odindino/UHV-Suitcase/README.md

# UHV-Suitcase
The suitcase design for UHV experiment

Materials
1. CF 35 blank/viewport
2. VAT Mini Gate Valve (CF35)
3. SAES Z100 ion pump
4. UHV Design wobblestick WSG40-300
5. Homemade 2x Sample holder and 2x tip holder
