odindino/UHV-Suitcase/Suitcase_odino_2025_rev-1/shelf/HS.SLDASM

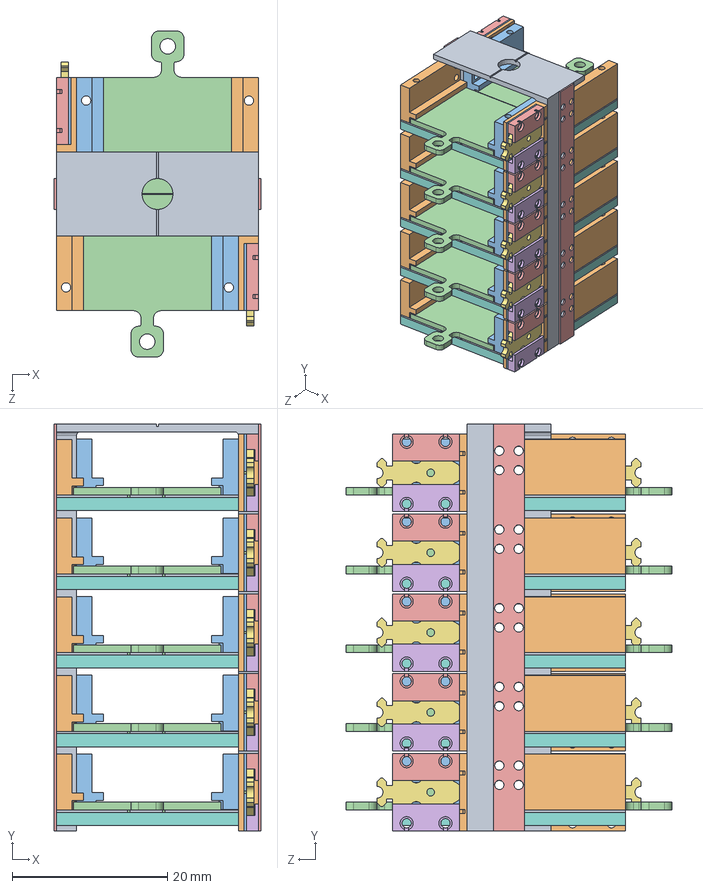
[picture p1: CAD file, 2025-01-05]
Suitcase_odino_2025_rev-1/shelf/HS.SLDASM
26.7 x 52.5 x 42.1 mm
sample shelf
tip holder bottom x 10
tip holder 蓋子 x 10
sample holder 彈片 x 30
tip holder left side x 10
tip holder right side x 10
normal-tip holder x 10
sample holder bottom x 10
sample holder lip x 10
sample holder one layer left side x 10
sample holder one layer right side x 10
flag style sample plate_ZL x 10
sample shelf 板子 x 2
