odindino/UHV-Suitcase/Suitcase_odino_2025_rev-1/wobble stick_tube_rotatable.SLDPRT.SLDASM

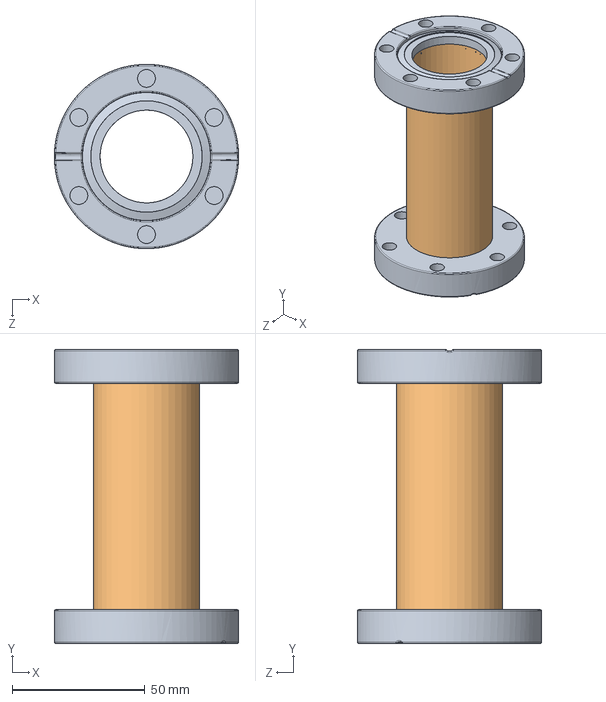
[picture p2: CAD file, 2025-01-05]
Suitcase_odino_2025_rev-1/wobble stick_tube_rotatable.SLDPRT.SLDASM
69.3 x 110.6 x 69.3 mm
P104704_Bored Conflat Flange, 2.750 inch, Bored 1.50 in., Through Holes, Rotatable x 2
wobble stick_tube
