odindino/UHV-Suitcase/Suitcase_odino_2025_rev-1/Ion pump_tube_rotatable.SLDASM

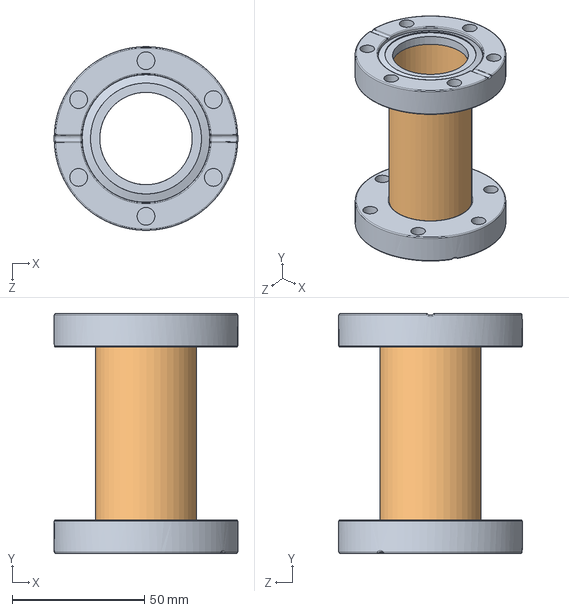
[picture p3: CAD file, 2025-01-05]
Suitcase_odino_2025_rev-1/Ion pump_tube_rotatable.SLDASM
69.3 x 90.6 x 69.3 mm
P104704_Bored Conflat Flange, 2.750 inch, Bored 1.50 in., Through Holes, Rotatable x 2
Ion pump_tube
