odindino/UHV-Suitcase/Suitcase_odino_2025_rev-1/Gate valve_tube_rotatable.SLDASM

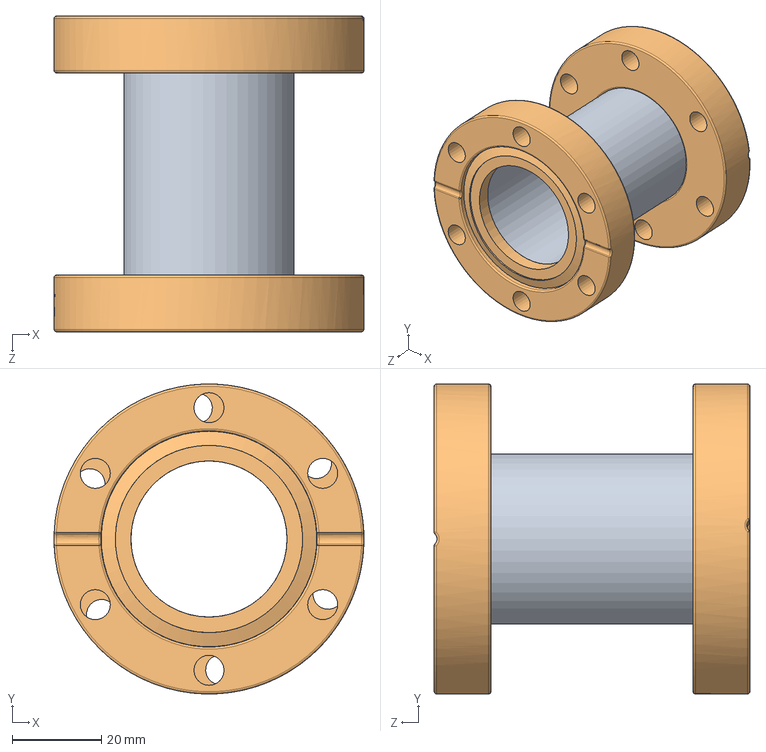
[picture p4: CAD file, 2025-01-05]
Suitcase_odino_2025_rev-1/Gate valve_tube_rotatable.SLDASM
69.3 x 69.3 x 70.6 mm
Gate valve_tube
P104704_Bored Conflat Flange, 2.750 inch, Bored 1.50 in., Through Holes, Rotatable x 2
