odindino/UHV-Suitcase/Suitcase_odino_2025_rev-1/shelf/HS-HS.SLDPRT

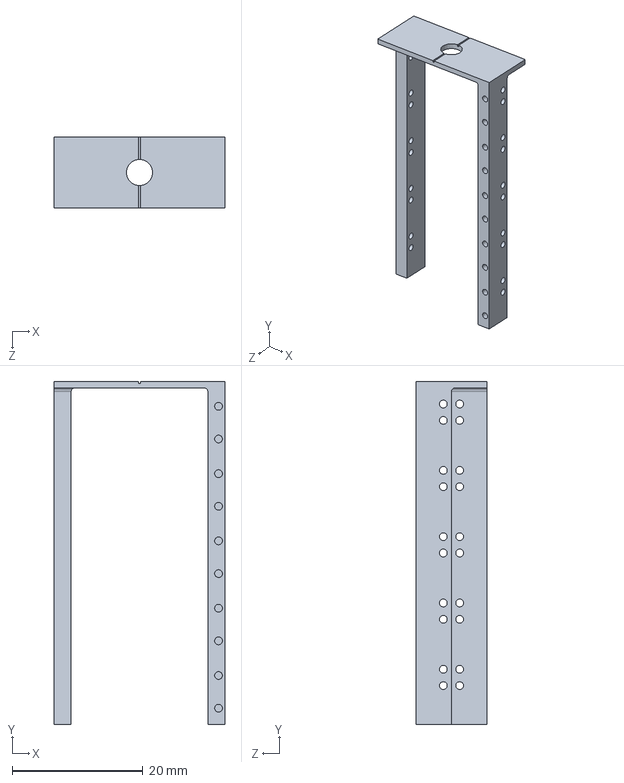
[picture p5: CAD file, 2025-01-05]
Suitcase_odino_2025_rev-1/shelf/HS-HS.SLDPRT
26.1 x 52.5 x 10.8 mm
