odindino/UHV-Suitcase/Suitcase_odino_2025_rev-1/wobble stick_tube.SLDPRT

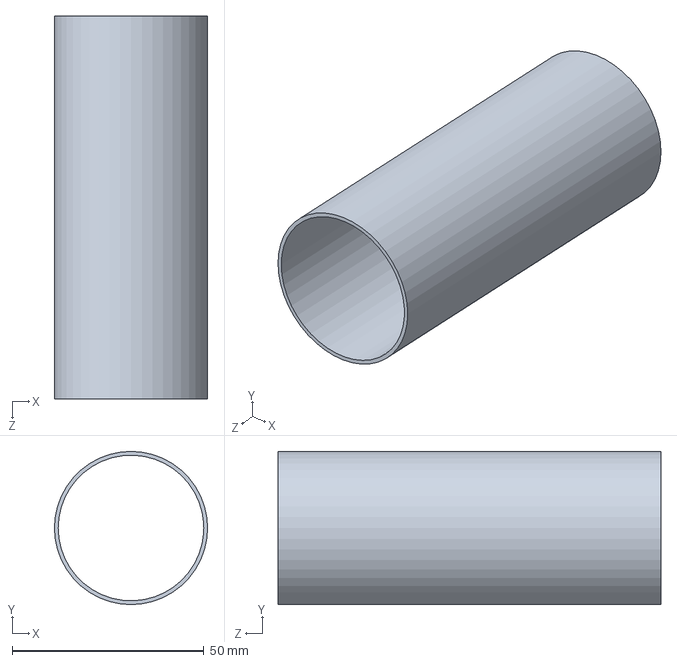
[picture p6: CAD file, 2025-01-05]
Suitcase_odino_2025_rev-1/wobble stick_tube.SLDPRT
40.0 x 40.0 x 100.0 mm
