odindino/UHV-Suitcase/Suitcase_odino_2025_rev-1/shelf/HS-HSB.SLDPRT

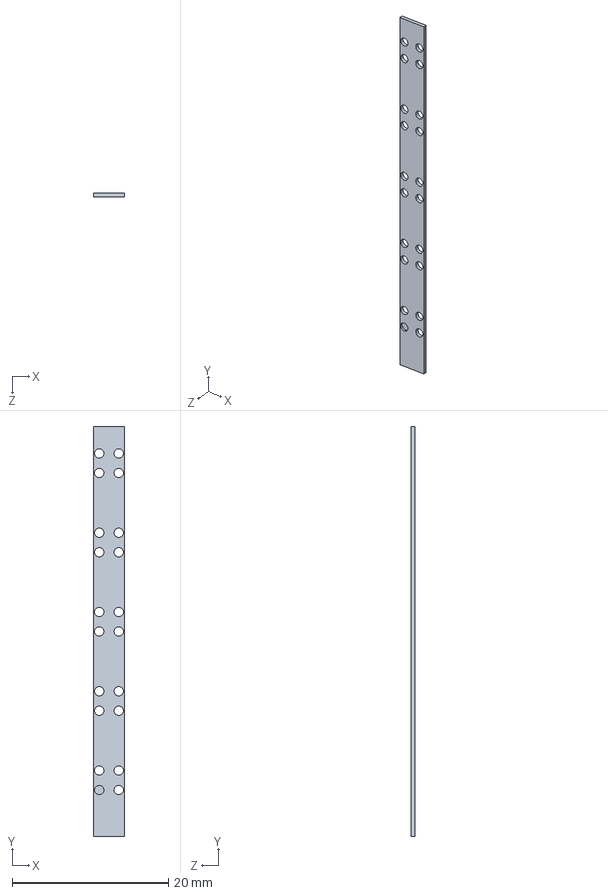
[picture p7: CAD file, 2025-01-05]
Suitcase_odino_2025_rev-1/shelf/HS-HSB.SLDPRT
4.00 x 52.5 x 0.5 mm
