odindino/UHV-Suitcase/Suitcase_odino_2025_rev-1/B1363B.step.SLDPRT

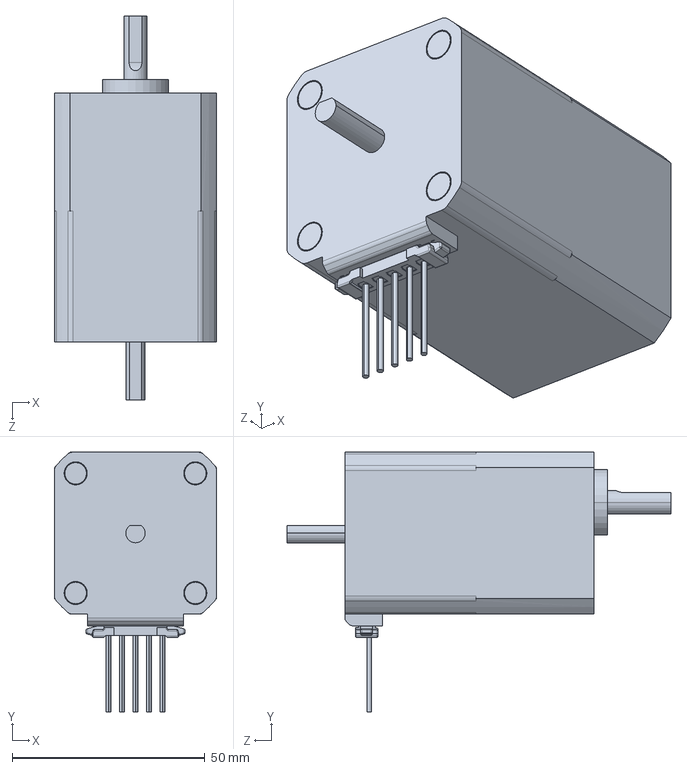
[picture p8: CAD file, 2025-01-05]
Suitcase_odino_2025_rev-1/B1363B.step.SLDPRT
42.0 x 67.3 x 99.5 mm
