odindino/UHV-Suitcase/Suitcase_odino_2025_rev-1/SAES-Z100.SLDPRT

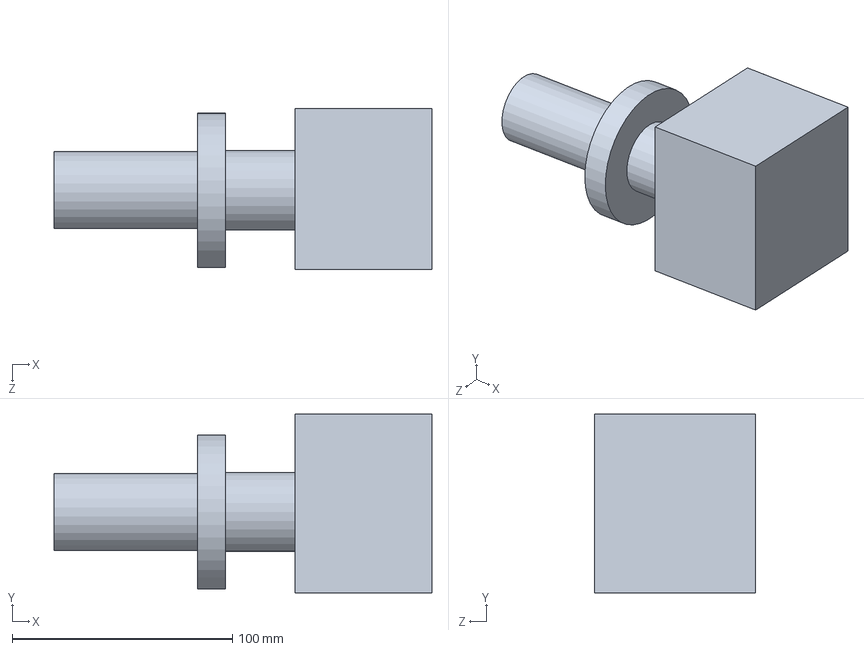
[picture p9: CAD file, 2025-01-05]
Suitcase_odino_2025_rev-1/SAES-Z100.SLDPRT
171.5 x 81.0 x 73.1 mm
