odindino/UHV-Suitcase/Suitcase_odino_2025_rev-1/shelf/HS-2_for 2SH2TH.SLDPRT

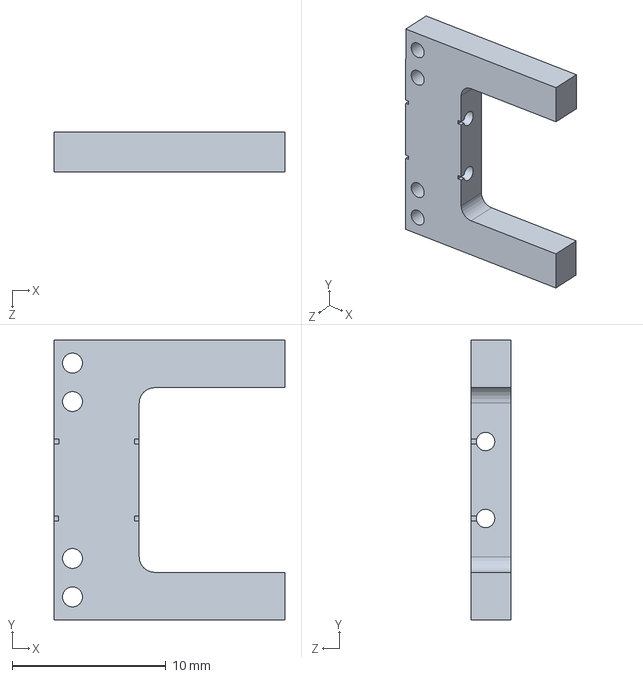
[picture p10: CAD file, 2025-01-05]
Suitcase_odino_2025_rev-1/shelf/HS-2_for 2SH2TH.SLDPRT
15.0 x 18.2 x 2.60 mm
