odindino/UHV-Suitcase/Suitcase_odino_2025_rev-1/wobble stick_tube_rotatable.SLDPRT

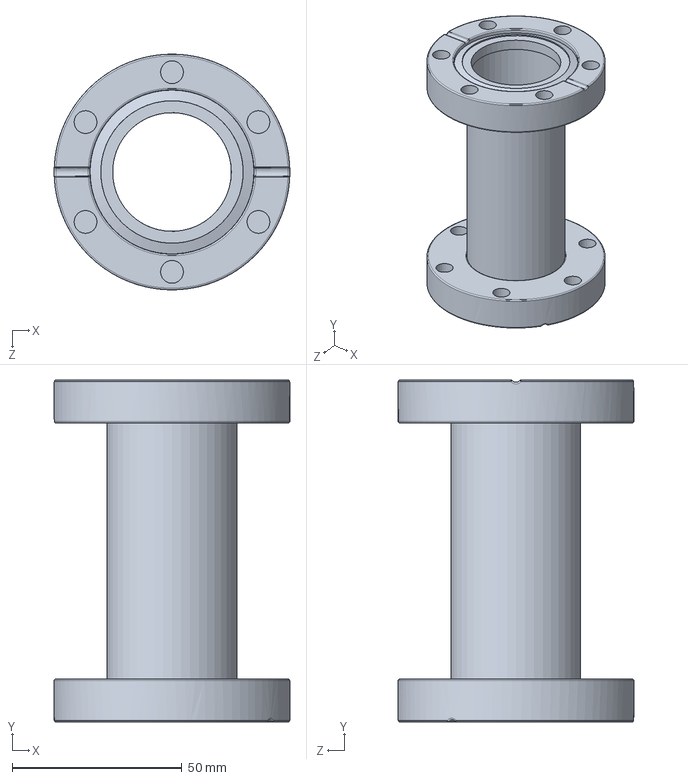
[picture p11: CAD file, 2025-01-05]
Suitcase_odino_2025_rev-1/wobble stick_tube_rotatable.SLDPRT
69.3 x 100.6 x 69.3 mm
