odindino/UHV-Suitcase/(list of files, cad)

Other CAD files:
Suitcase_odino_2025_rev-1/WSG40-300-FI(0)(0)(0)(C).sldasm
Suitcase_odino_2025_rev-1/WSG-SHAFT (300)(C).sldprt
Suitcase_odino_2025_rev-1/shelf/HS-2_Top.SLDPRT
Suitcase_odino_2025_rev-1/Ion pump_tube.SLDPRT
Suitcase_odino_2025_rev-1/shelf/HS-2-BS_for 2SH2TH.SLDPRT
Suitcase_odino_2025_rev-1/WSG-FLANGE.sldprt
Suitcase_odino_2025_rev-1/WSG40-H-THIMBLE.sldprt
Suitcase_odino_2025_rev-1/WSG-BELLOW.sldprt
Suitcase_odino_2025_rev-1/WSG40-H-BASE.sldprt
Suitcase_odino_2025_rev-1/Gate valve_tube.SLDPRT
Suitcase_odino_2025_rev-1/315370A.stp
Suitcase_odino_2025_rev-1/Gate valve_tube_rotatable.SLDPRT
Suitcase_odino_2025_rev-1/Ion pump_tube_rotatable.SLDPRT
Suitcase_odino_2025_rev-1/P104704_Bored Conflat Flange, 2.750 inch, Bored 1.50 in., Through Holes, Rotatable.sldprt
Suitcase_odino_2025_rev-1/P104786_Conflat Flange (CF) 6-Way Cube, CF 2.75 inch.sldprt
Suitcase_odino_2025_rev-1/shelf/HS-2-BS_for 2SH2TH.SLDDRW
Suitcase_odino_2025_rev-1/shelf/HS-2_Top.SLDDRW
Suitcase_odino_2025_rev-1/shelf/HS-2_for 2SH2TH.SLDDRW
